ryood/SQR_FG/cad/P1070730.jpg

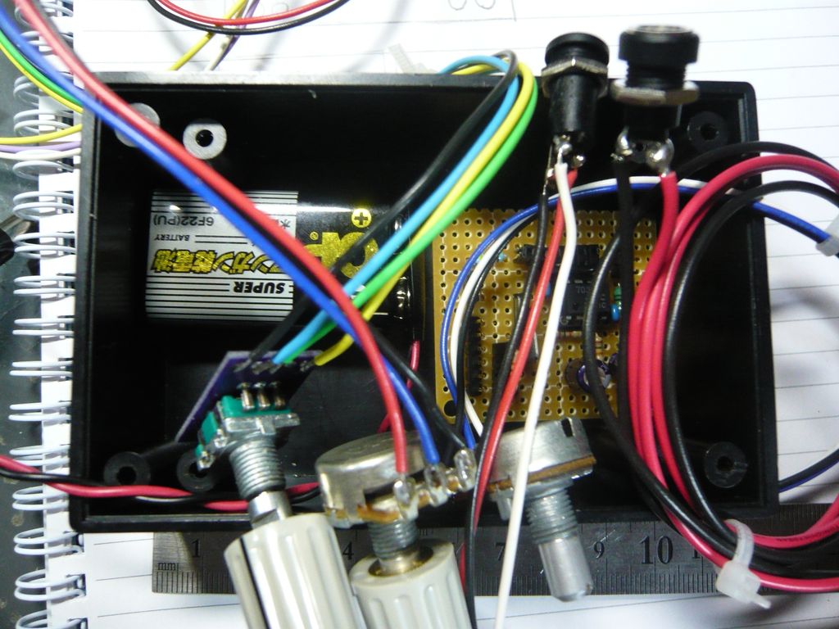
cad/P1070730.jpg
