ryood/SQR_FG/fritzing/SQR_FG_ケース内配線_Ver.2_ブレッドボード.png

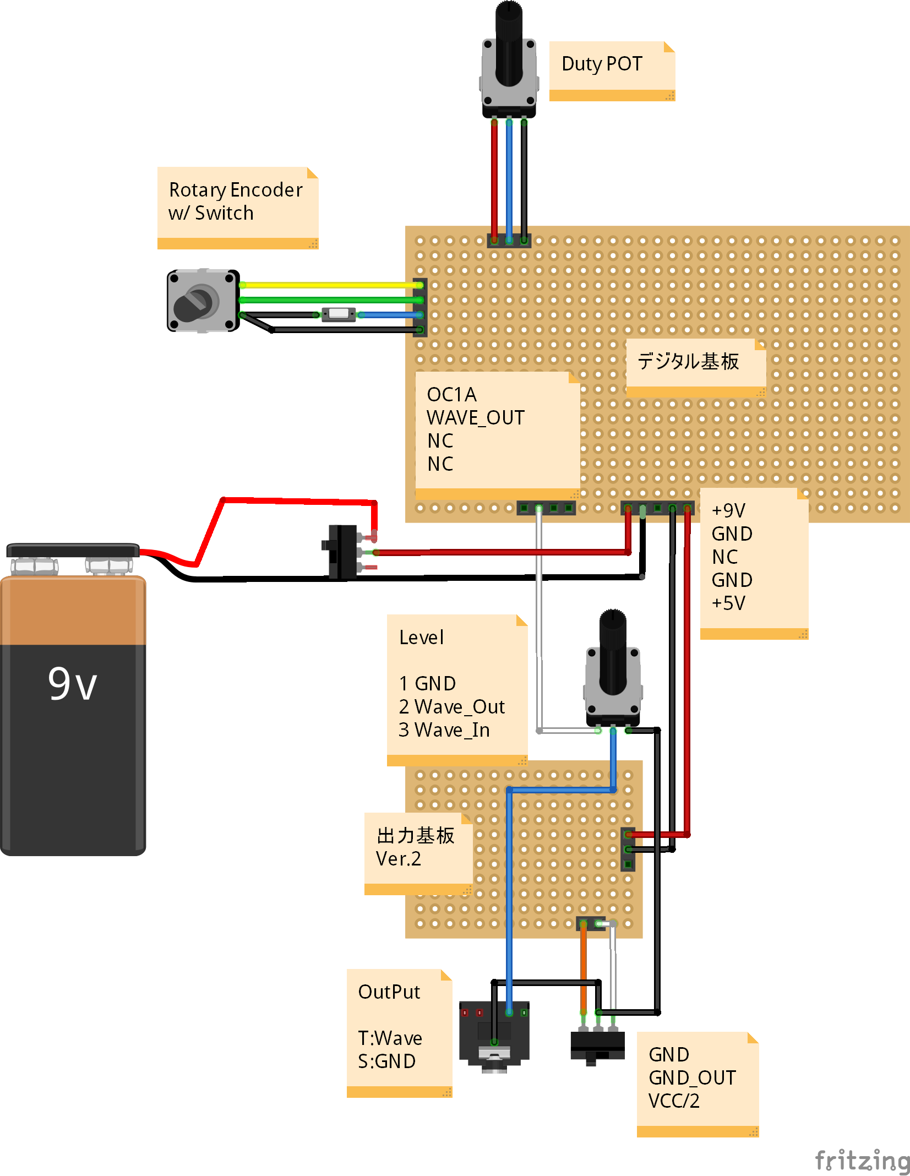
fritzing/SQR_FG_ケース内配線_Ver.2_ブレッドボード.png
