ryood/SQR_FG/SQR_FG_Digital_Board_Brd.png

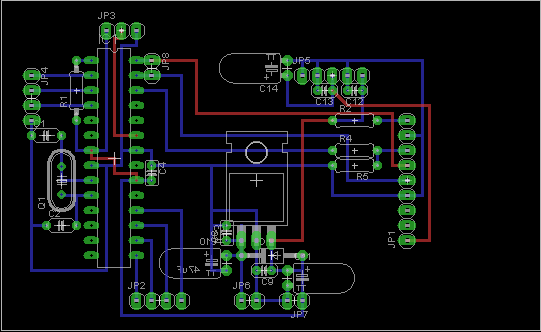
SQR_FG_Digital_Board_Brd.png
