ryood/SQR_FG/SQR_FG_Digital_Board_Sch.png

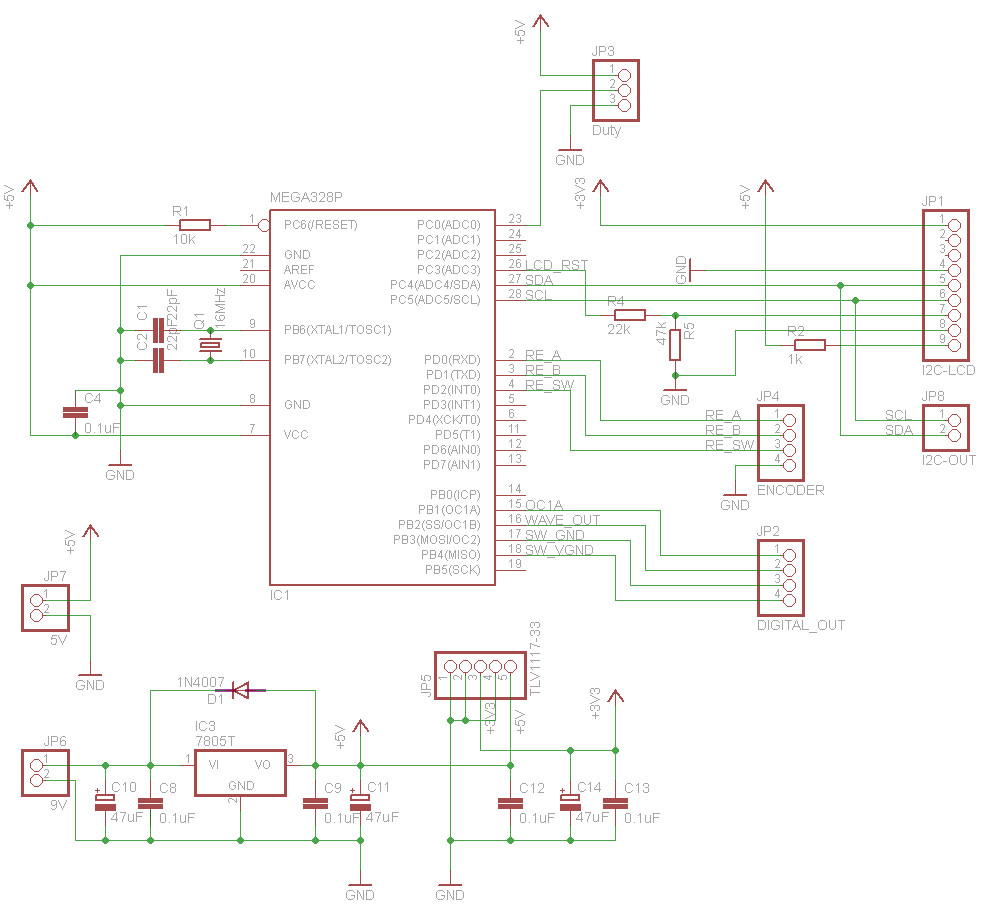
SQR_FG_Digital_Board_Sch.png
