ryood/SQR_FG/SQR_FG_Simple_Output_Brd.png

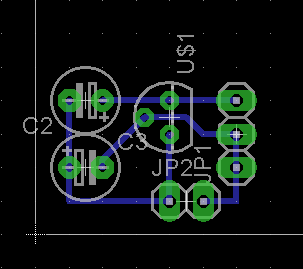
SQR_FG_Simple_Output_Brd.png
