ryood/SQR_FG/SQR_FG_Simple_Output_Sch.png

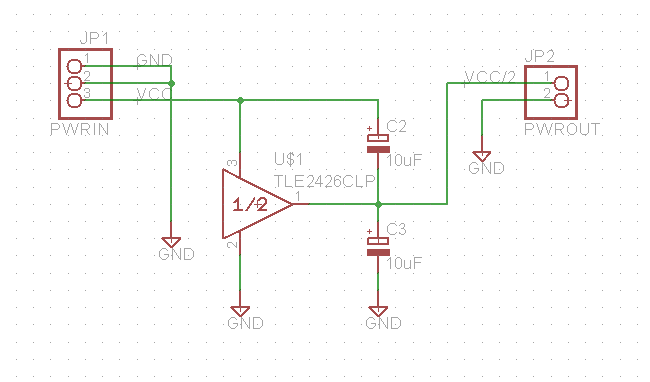
SQR_FG_Simple_Output_Sch.png
