ryood/SQR_FG/(list of files, cad)

Other CAD files:
cad/SQR_FG_Case.dwg
