ryood/SQR_FG/(list of files, drawings)

Other design files:
fritzing/SQ_FG_Simple_Output_Test.fzz
fritzing/SQR_FG_ケース内配線_Ver.2.fzz
