ryood/SQR_FG/eagle/Digital_Output.brd

## EAGLE design eagle/Digital_Output.brd (2015-12-04)

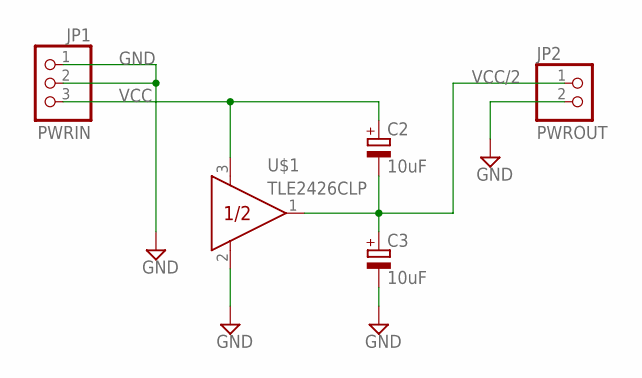
[picture p7: schematic Digital_Output.sch]

Parts:
C2, C3: 10uF; E2,5-5
JP1: PWRIN; 1X03
JP2: PWROUT; 1X02
U$1: TLE2426CLP; TO226AA

Connections:
GND: C3.-, JP1.1, JP1.2, JP2.2, U$1.2 (COM)
VCC: C2.+, JP1.3, U$1.3 (IN)
VCC/2: C2.-, C3.+, JP2.1, U$1.1 (OUT)

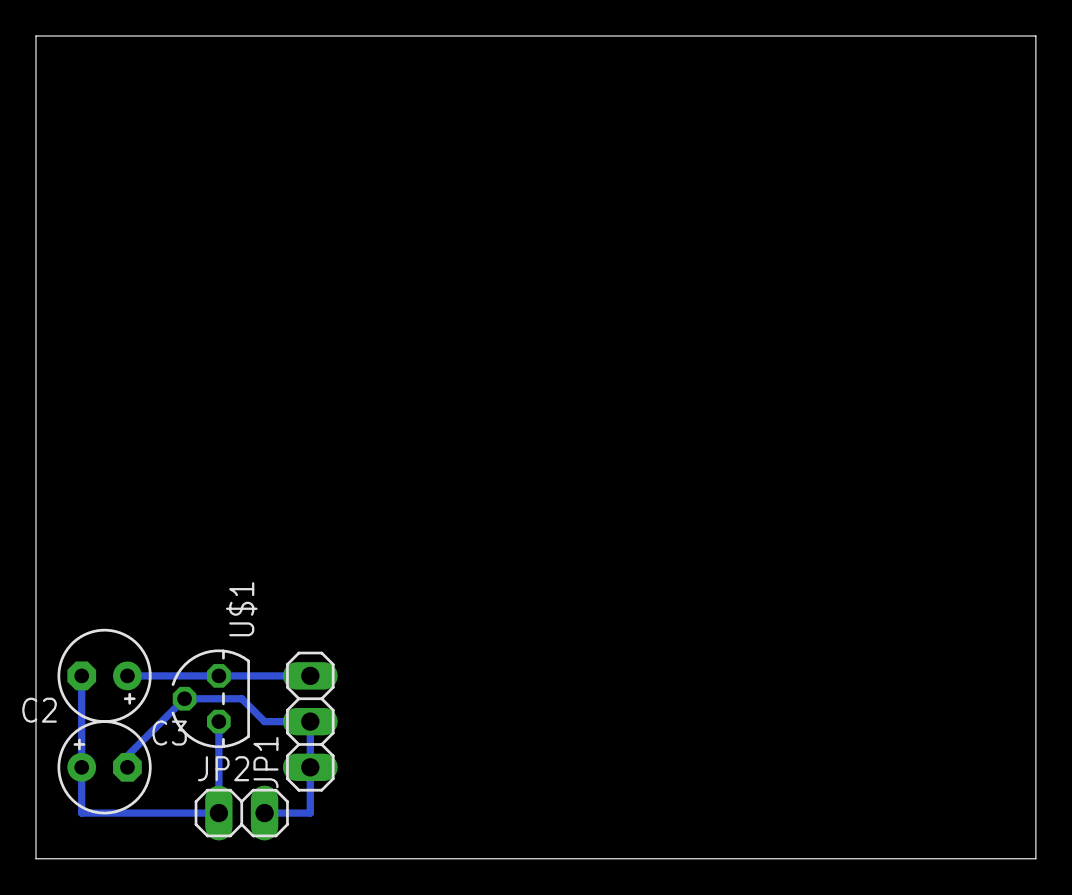
[picture p8: board Digital_Output.brd from above]

Board: 2 copper layers, 55.5 x 45.7 mm, 5 parts (0 on the bottom side), 3 nets.
