ryood/SQR_FG/eagle/SQR_FG_Digital.brd

## EAGLE design eagle/SQR_FG_Digital.brd (2015-05-28)

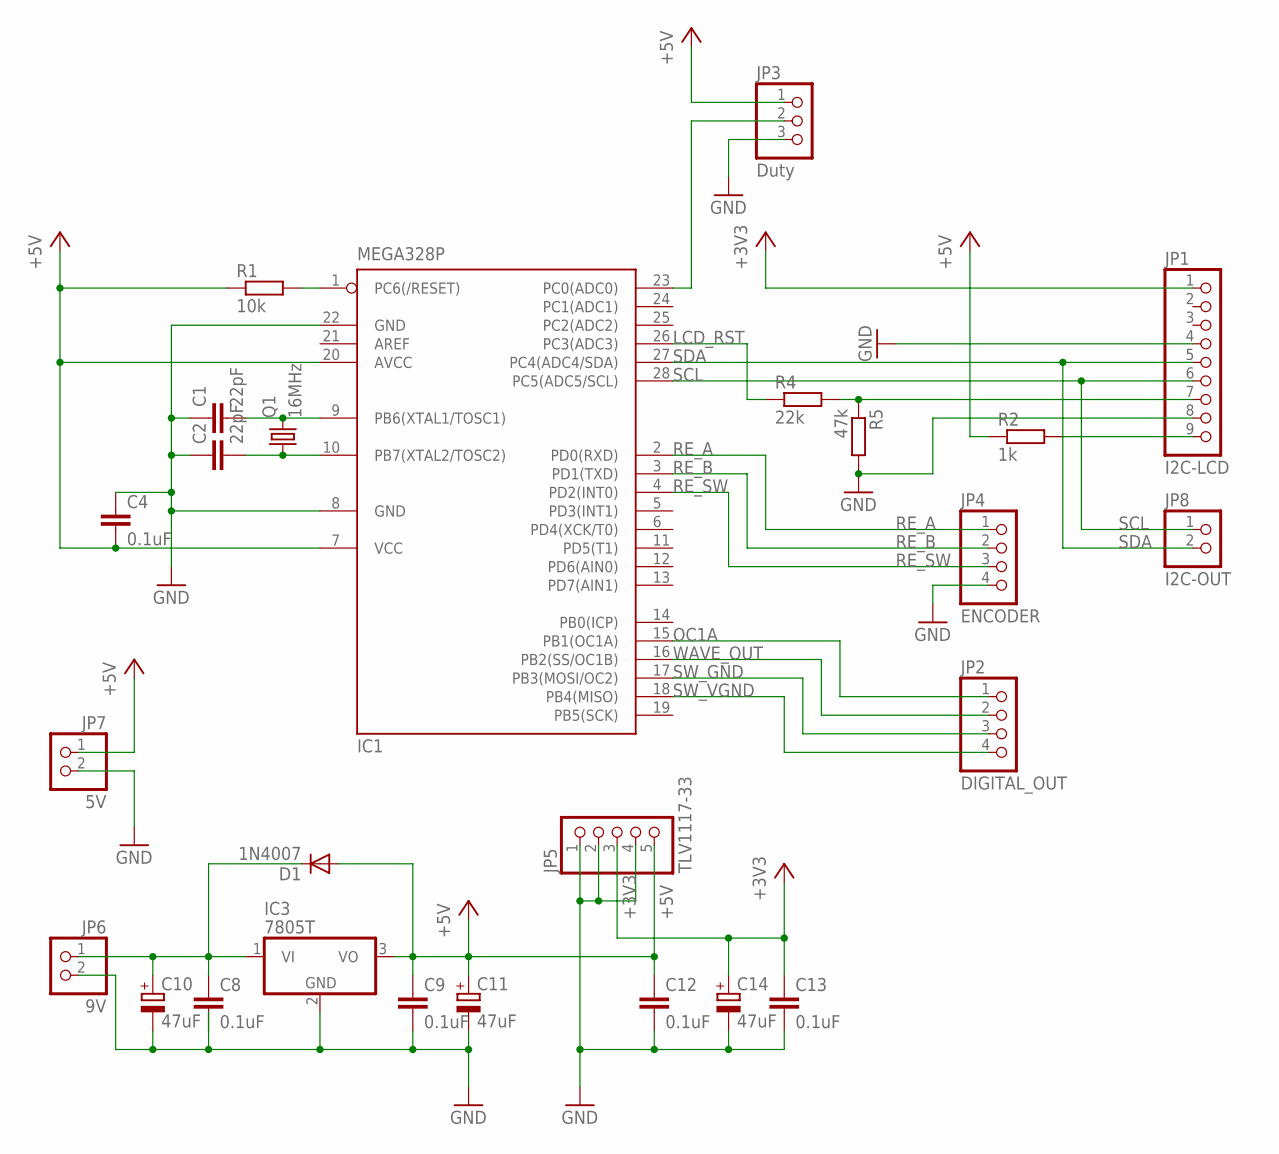
[picture p9: schematic SQR_FG_Digital.sch]

Parts:
C1, C2: 22pF; C050-024X044
C4, C8, C9, C12, C13: 0.1uF; C025-024X044
C10, C11, C14: 47uF; TT2D5L
D1: 1N4007; DO41-10
IC1: MEGA328P; DIL28-3
IC3: 7805T; TO220H
JP1: I2C-LCD; 1X09
JP2: DIGITAL_OUT; 1X04
JP3: Duty; 1X03
JP4: ENCODER; 1X04
JP5: TLV1117-33; 1X05
JP6: 9V; 1X02
JP7: 5V; 1X02
JP8: I2C-OUT; 1X02
Q1: 16MHz; HC49/S
R1: 10k; 0207/10
R2: 1k; 0207/7
R4: 22k; 0207/7
R5: 47k; 0207/7

Connections:
+3V3: C13.1, C14.+, JP1.1, JP5.3
+5V: C4.2, C9.1, C11.+, C12.1, D1.A, IC1.7 (VCC), IC1.20 (AVCC), IC3.3 (VO), JP3.1, JP5.5, JP7.1, R1.1, R2.1
GND: C1.1, C2.1, C4.1, C8.2, C9.2, C10.-, C11.-, C12.2, C13.2, C14.-, IC1.8 (GND), IC1.22 (GND), IC3.2 (GND), JP1.4, JP1.8, JP3.3, JP4.4, JP5.1, JP5.2, JP5.4, JP6.2, JP7.2, R5.2
LCD_RST: IC1.26 (PC3(ADC3)), R4.1
unnamed: C1.2, IC1.9 (PB6(XTAL1/TOSC1)), Q1.2
unnamed: C2.2, IC1.10 (PB7(XTAL2/TOSC2)), Q1.1
unnamed: IC1.1 (PC6(/RESET)), R1.2
unnamed: C8.1, C10.+, D1.C, IC3.1 (VI), JP6.1
unnamed: JP1.9, R2.2
unnamed: IC1.23 (PC0(ADC0)), JP3.2
OC1A: IC1.15 (PB1(OC1A)), JP2.1
RE_A: IC1.2 (PD0(RXD)), JP4.1
RE_B: IC1.3 (PD1(TXD)), JP4.2
RE_SW: IC1.4 (PD2(INT0)), JP4.3
RST: JP1.7, R4.2, R5.1
SCL: IC1.28 (PC5(ADC5/SCL)), JP1.6, JP8.1
SDA: IC1.27 (PC4(ADC4/SDA)), JP1.5, JP8.2
SW_GND: IC1.17 (PB3(MOSI/OC2)), JP2.3
SW_VGND: IC1.18 (PB4(MISO)), JP2.4
WAVE_OUT: IC1.16 (PB2(SS/OC1B)), JP2.2

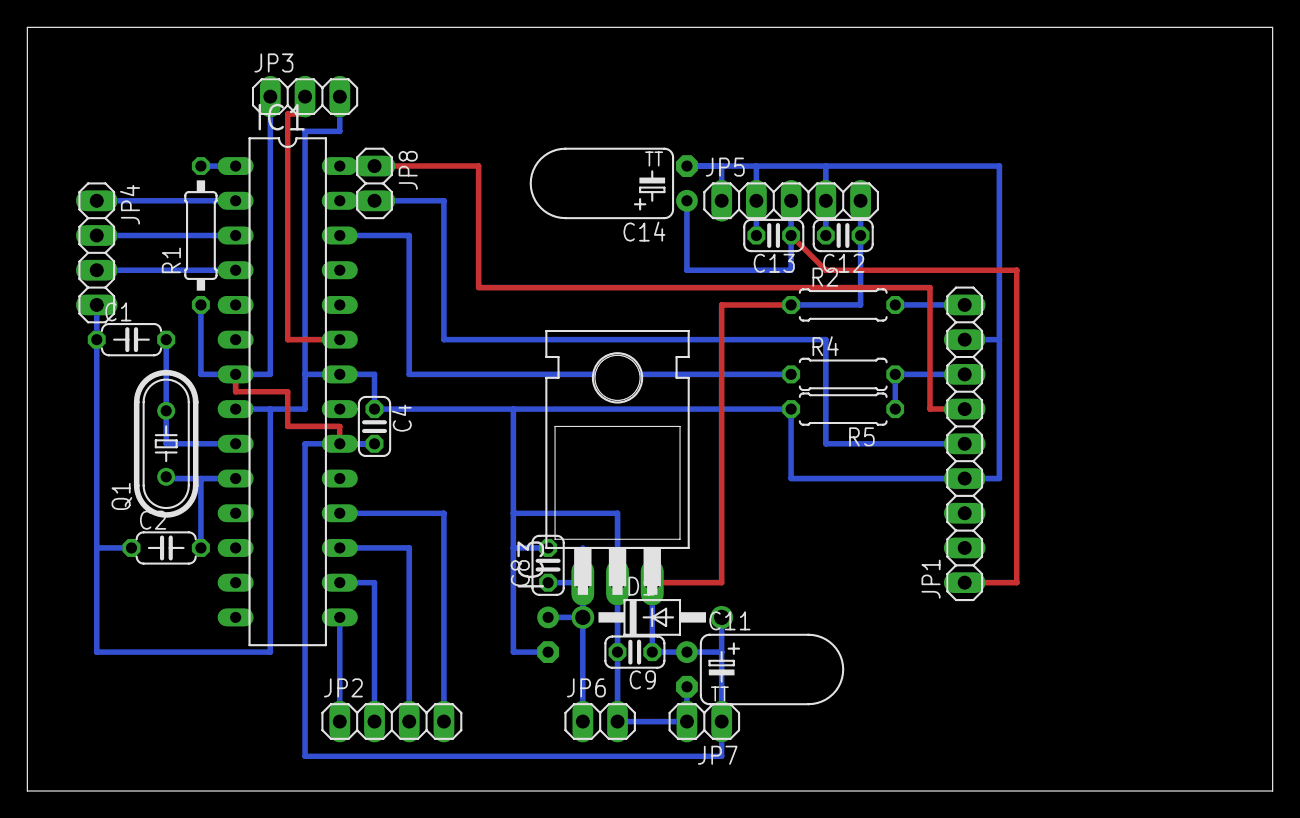
[picture p10: board SQR_FG_Digital.brd from above]

Board: 2 copper layers, 91.1 x 55.9 mm, 26 parts (1 on the bottom side), 20 nets.
