ryood/SQR_FG/eagle/SQR_FG_Output.brd

## EAGLE design eagle/SQR_FG_Output.brd (2015-06-06)

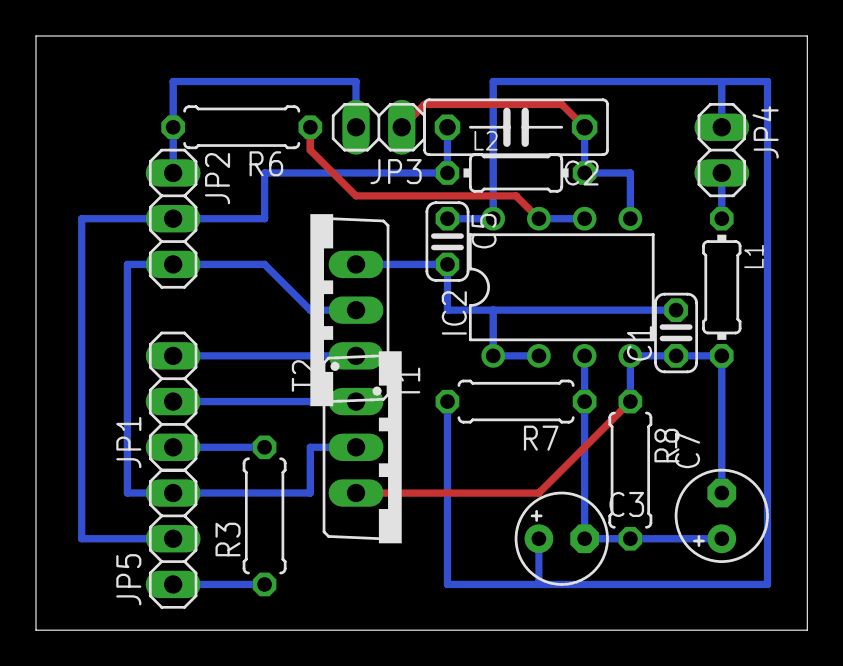
[picture p11: board SQR_FG_Output.brd from above]

Board: 2 copper layers, 42.9 x 33.0 mm, 19 parts (0 on the bottom side), 14 nets.

Parts:
C1, C5: 0.1uF; C025-024X044
C2: 100p; C075-032X103
C3, C7: 100uF; E2,5-5
IC2: NJU7032; DIL08
JP1: DIGITAL_IN; 1X03
JP2: OUT; 1X03
JP3: BYPASS_BUFFER; 1X02
JP4: 5VIN; 1X02
JP5: Level; 1X03
L1, L2: 1uH; 0204/7
R3: 1k; 0207/7
R6: 47; 0207/7
R7, R8: 10k; 0207/7
T1, T2: 2SK4017; TO220BV

Connections:
+5V: C3.+, C5.1, IC2.8, JP4.1, R7.2
AGND: C1.1, C7.-, IC2.4, L1.2, R8.1, T2.S
BUFFERD: JP2.1, JP3.2, R6.2
BYPASS: C2.2, JP2.2, JP5.2, L2.1
GND: JP4.2, L1.1
GND_OUT: JP2.3, JP5.3, T1.D, T2.D
unnamed: C2.1, IC2.5, JP3.1, L2.2
unnamed: JP5.1, R3.1
unnamed: IC2.6, IC2.7, R6.1
unnamed: C3.-, C7.+, IC2.3, R7.1, R8.2
SW_GND: JP1.2, T2.G
SW_VGND: JP1.3, T1.G
VGND: C1.2, C5.2, IC2.1, IC2.2, T1.S
WAVE_OUT: JP1.1, R3.2
