ryood/SQR_FG/fritzing/SQ_FG_Simple_Output_Test_ブレッドボード.png

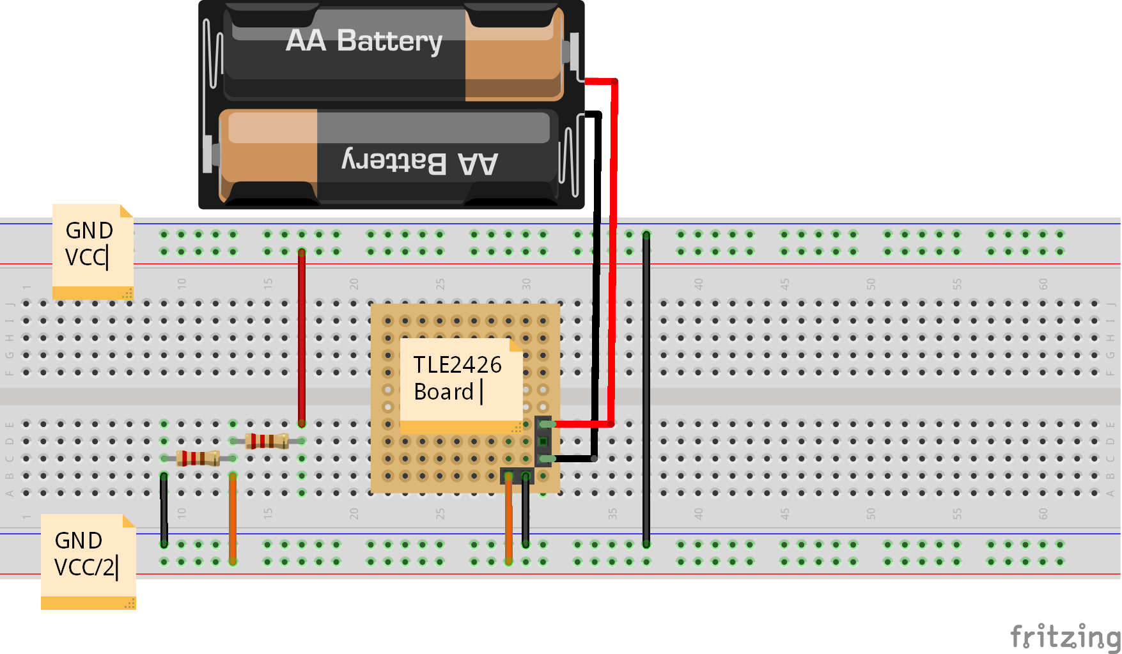
fritzing/SQ_FG_Simple_Output_Test_ブレッドボード.png
