ryood/SQR_FG/(commit log)

2015-05-11 Add Eagle files
    [SQR_FG.brd, SQR_FG.sch]
2015-05-11 eagle: Add Bypass Connector
    [SQR_FG.brd, SQR_FG.sch]
2015-05-11 Add LTSpice & Fritzing files
    [3.3VAVR_I2CLCD.fzz, 3.3VAVR_I2CLCD_aitendo.fzz, 5V-3_3V_Regulator.fzz, 5VAVR_3.3VI2CLCD-aitendo-NO-Level-Shift-Ext.Crystal.fzz, 5VAVR_3.3VI2CLCD-aitendo-NO-Level-Shift-Ext.Crystal_9VPower.fzz, 5VAVR_3.3VI2CLCD-aitendo-NO-Level-Shift.fzz, 5VAVR_3.3VI2CLCD-aitendo.fzz, 5VAVR_3.3VI2CLCD.fzz]
2015-05-11 Add MOS-FET Switching
    [MOS-FET_Switching_Test.fzz, SQR_FG_Test.fzz]
2015-05-11 Change eagle SQR_FG.sch R value
    [SQR_FG.brd, SQR_FG.sch]
2015-05-11 SQR_FG.c: implement Rotary Encoder SW GND or VGND
2015-05-14 SQR_FG_Test.fzz Update
    [SQR_FG_Test.fzz]
2015-05-14 SQR_FG_Test.fzz: Update
    [SQR_FG_Test.fzz]
2015-05-14 SQR_FG.c: impliment I2C-LCD, Bug fix cycle bound bug
    [SPLC792-I2C.c, SPLC792-I2C.h, SQR_FG.c]
2015-05-14 before editing SQR_FG.brd
    [SQR_FG.sch]
2015-05-17 SQR_FG.brd SQR_FG board design editing.
    [SQR_FG.brd, SQR_FG.sch]
2015-05-17 eagle files: デジタル部と出力部に基板を分割
    [SQR_FG_Digital.brd, SQR_FG_Digital.sch, SQR_FG_Output.brd, SQR_FG_Output.sch]
2015-05-26 SQR_FG_Digital: I2Cの信号をピンソケットで出力できるように変更
    [SQR_FG_Digital.brd, SQR_FG_Digital.sch, SQR_FG_Output.brd, SQR_FG_Output.sch]
2015-05-26 fritzingにケース内配線図を追加
    [SQR_FG_ケース内配線.fzz]
2015-05-28 SQR_FG_Digital.sch: LCDのRST信号の分圧抵抗を変更
    [SQR_FG_Digital.brd, SQR_FG_Digital.sch]
2015-05-28 SQR_FG.c: SQR WAV, Impulse, Stepの実装OK
2015-06-02 SQR_FG_ケース内配線.fzz 修正
    [SQR_FG_ケース内配線.fzz]
2015-06-03 SQR_FG.c 初期周波数を1000Hzに変更
2015-06-03 SQR_FG_Output.sch LC 2次LPFを追加
    [SQR_FG_Output.brd, SQR_FG_Output.sch]
2015-06-06 ケース内配線図： ケーブルの色を変更
    [SQR_FG_ケース内配線.fzz]
2015-06-06 SQR_FG_Output.sch, brd: MOS-FETのGate, Drain, Sourceの並びを修正
    [SQR_FG_Output.brd, SQR_FG_Output.sch]
2015-06-10 SQR_FG_ケース内配線.fzz: 出力用のStereominiプラグを2系統に変更
    [SQR_FG_ケース内配線.fzz]
2015-06-10 cad¥: ケース加工図を追加
    [SQR_FG_Case.dwg]
2015-06-10 SQR_FG_Case.dwg: Update
    [SQR_FG_Case.dwg]
2015-06-21 SQR_FG_Case.dwg: ケース加工図修正
    [SQR_FG_Case.dwg]
2015-06-21 テスト表追加
    [SQR_FG デジタル部 テスト表-20150618.xlsx, SQR_FG デジタル部 テスト表.xlsx, SQR_FG 出力部テスト表 2015.06.06.xlsx]
2015-09-17 Add: LogicIC-Filter.zip
2015-12-04 Version 2
    [3.3VAVR_I2CLCD.fzz, 3.3VAVR_I2CLCD_aitendo.fzz, 5V-3_3V_Regulator.fzz, 5VAVR_3.3VI2CLCD-aitendo-NO-Level-Shift-Ext.Crystal.fzz, 5VAVR_3.3VI2CLCD-aitendo-NO-Level-Shift-Ext.Crystal_9VPower.fzz, 5VAVR_3.3VI2CLCD-aitendo-NO-Level-Shift.fzz, 5VAVR_3.3VI2CLCD-aitendo.fzz, 5VAVR_3.3VI2CLCD.fzz]
2015-12-04 出力部のEagleファイルを変更
    [Digital_Output.brd, Digital_Output.sch, SQR_FG_Output.sch]
2015-12-04 デジタル部の回路図、基板図のPNGファイルを追加
2015-12-04 Add: SQR_FG_出力周波数表.xlsx
    [SQR_FG_出力周波数表.xlsx]
